Netfreak25/TB2-C3-Dev-Shield/assets/pcb-top.png

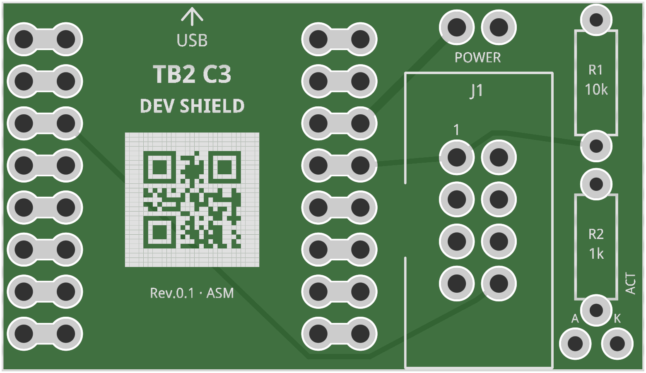
assets/pcb-top.png
