Netfreak25/TB2-C3-Dev-Shield/assets/schematic.png

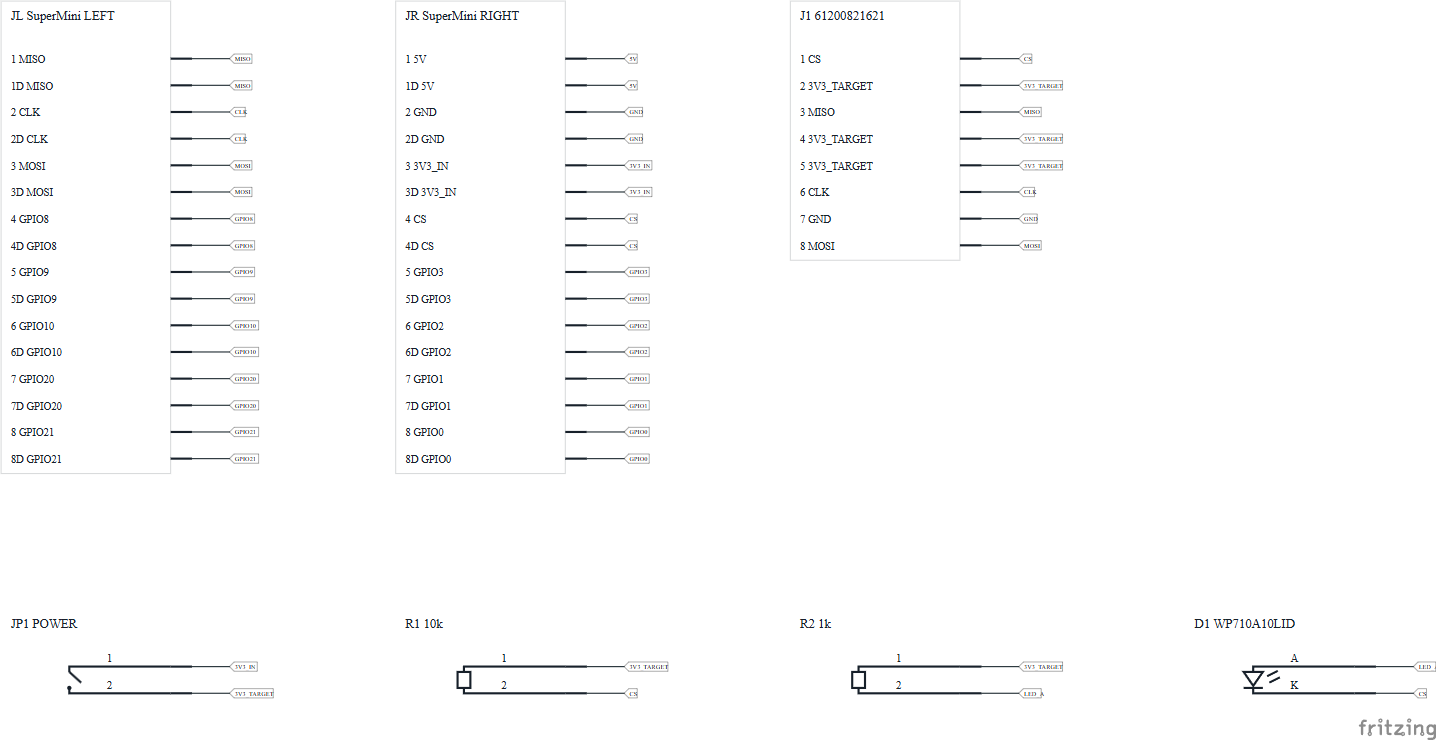
assets/schematic.png
