Netfreak25/TB2-C3-Dev-Shield/enclosure/model-b/exploded.png

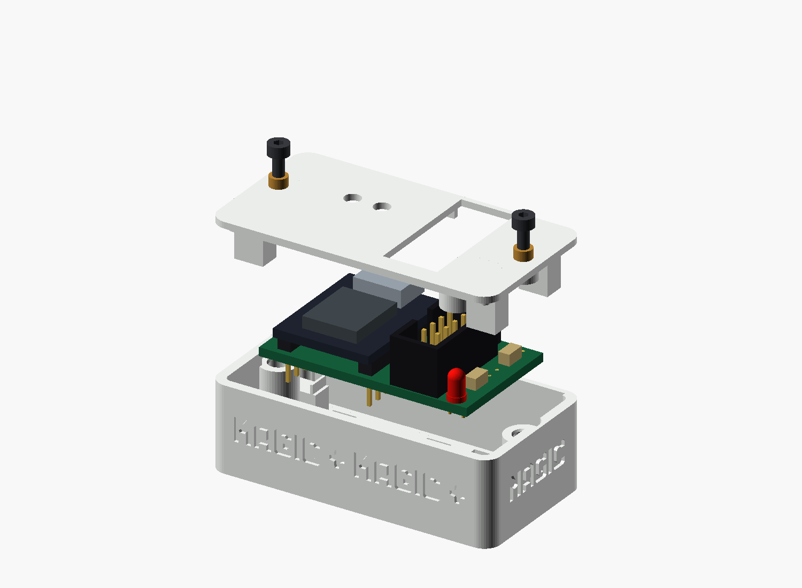
enclosure/model-b/exploded.png
