Netfreak25/TB2-C3-Dev-Shield/enclosure/model-b/led_section.png

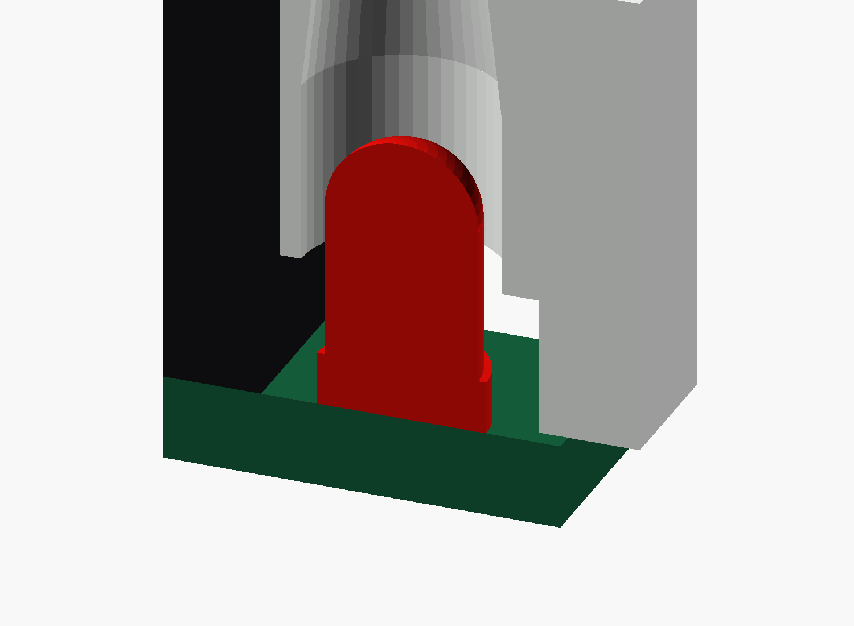
enclosure/model-b/led_section.png
