Netfreak25/TB2-C3-Dev-Shield/enclosure/model-b/usb_front.png

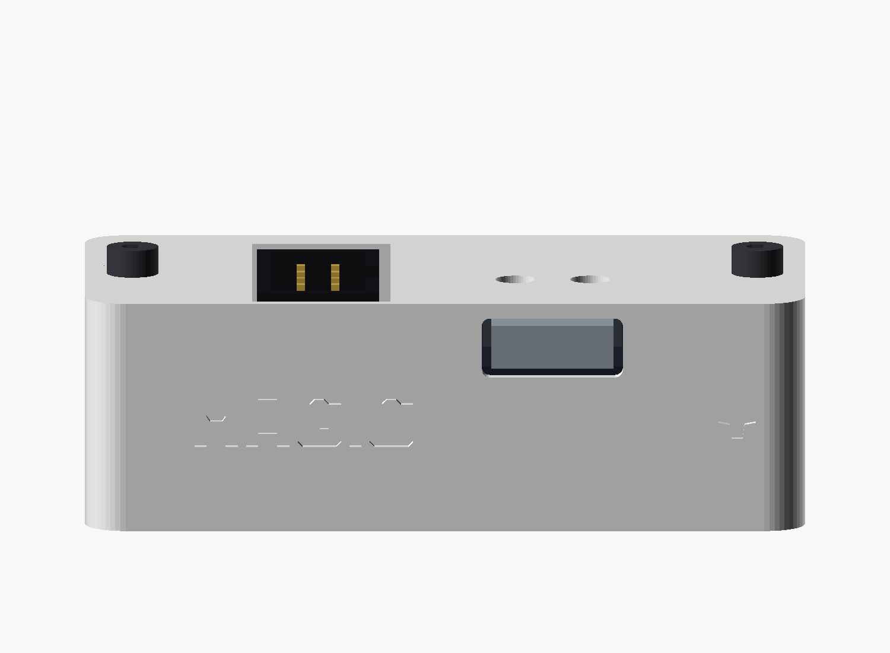
enclosure/model-b/usb_front.png
