Netfreak25/TB2-C3-Dev-Shield/manufacturing/pcbway/BOM.csv

Designator | Quantity | Description | Value | Footprint | Manufacturer | MPN | Mounting | Notes | Datasheet
JL,JR | 2 | Female socket strip 1x8 | 2.54 mm; 8.5 mm body height | THT; body 20.82 x 2.5 mm | Wurth Elektronik | 61300811821 | THT TOP | Inner rows only; sockets open upward; 15.24 mm row spacing. | https://www.we-online.com/components/products/datasheet/61300811821.pdf
J1 | 1 | Straight vertical shrouded Stecker 2x4 | 2.54 mm | THT; body 9.0 x 17.82 mm | Wurth Elektronik | 61200821621 | THT TOP | Notch LEFT; opening UP; pin 1 at USB end. Do not fit a right-angle type. | https://www.we-online.com/components/products/datasheet/61200821621.pdf
JP1 | 1 | Power header 1x2 WITHOUT SHUNT | 2.54 mm; 6 mm mating pins | THT; 1.10 mm PCB holes | Wurth Elektronik | 61300211121 | THT TOP | Fit the two-pin header only. DO NOT supply or fit a removable shunt. Leave open. | https://www.we-online.com/components/products/datasheet/61300211121.pdf
R1 | 1 | CS pull-up resistor | 10 kohm; 1%; 0.25 W | THT axial; form leads to 7.62 mm; body max 3.7 x 2.1 mm | Yageo | MFR25SFTE52-10K | THT TOP | Equivalent by stated specs allowed; horizontal body; no polarity. | https://yageogroup.com/content/datasheet/asset/file/YAGEO-MFR_DATASHEET
R2 | 1 | ACT LED series resistor | 1 kohm; 1%; 0.25 W | THT axial; form leads to 7.62 mm; body max 3.7 x 2.1 mm | Yageo | MFR25SFTE52-1K | THT TOP | Equivalent by stated specs allowed; horizontal body; no polarity. | https://yageogroup.com/content/datasheet/asset/file/YAGEO-MFR_DATASHEET
D1 | 1 | Red low-current ACT LED | 3 mm red; low-current indicator | THT; 2.54 mm pitch | Kingbright | WP710A10LID | THT TOP | Anode LEFT; cathode RIGHT (flat side). Mount upright; verify datasheet polarity. | https://www.kingbrightusa.com/images/catalog/SPEC/WP710A10LID.pdf
