Netfreak25/TB2-C3-Dev-Shield/enclosure/model-b/TB2_C3_Case_B_corrected.3mf

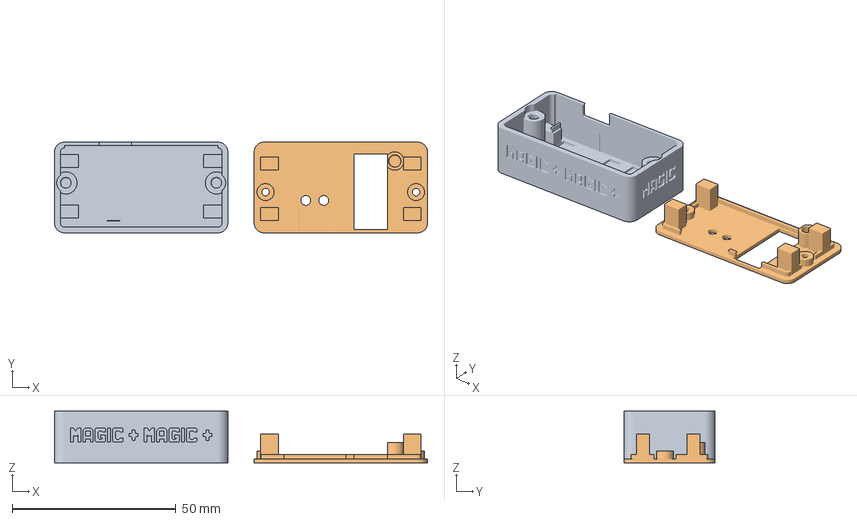
[picture p17: CAD file, 2026-10-26]
enclosure/model-b/TB2_C3_Case_B_corrected.3mf
114.0 x 27.7 x 15.8 mm
Base
Lid
