Netfreak25/TB2-C3-Dev-Shield/enclosure/TB2_C3_Case_base.stl

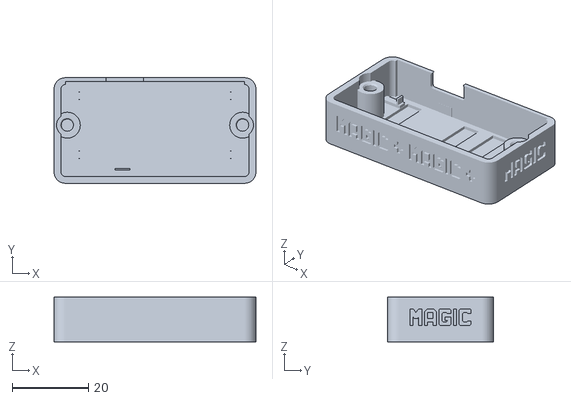
[picture p18: CAD file, 2026-10-26]
enclosure/TB2_C3_Case_base.stl
53.0 x 27.7 x 11.8
