Netfreak25/TB2-C3-Dev-Shield/enclosure/TB2_C3_Case_lid.stl

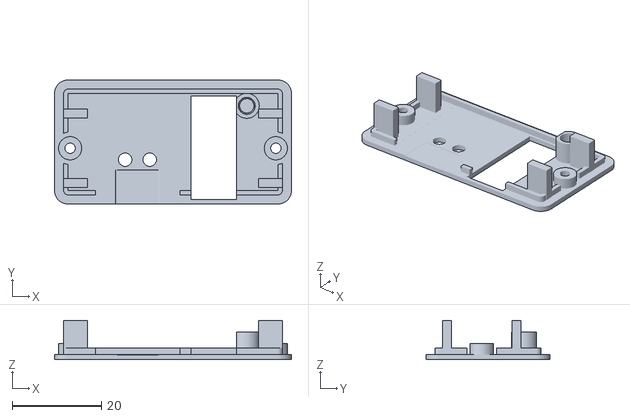
[picture p20: CAD file, 2026-10-26]
enclosure/TB2_C3_Case_lid.stl
53.0 x 27.7 x 8.80
