Netfreak25/TB2-C3-Dev-Shield/enclosure/model-b/TB2_C3_Case_base.stl

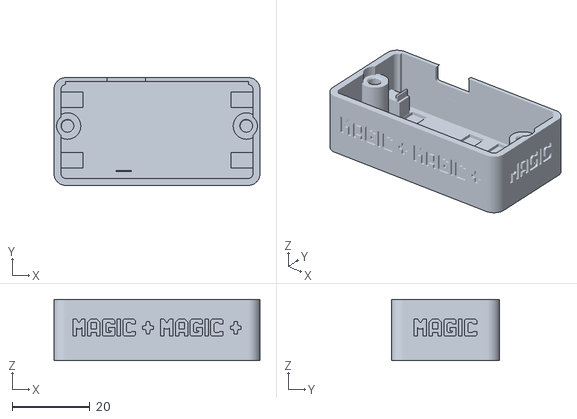
[picture p21: CAD file, 2026-10-26]
enclosure/model-b/TB2_C3_Case_base.stl
53.0 x 27.7 x 15.8
