Netfreak25/TB2-C3-Dev-Shield/(list of files, drawings)

Other design files:
hardware/TB2-C3-Dev-Shield-Assembly-Rev0.1.fzz
