Netfreak25/TB2-C3-Dev-Shield/(commit log)

2026-10-10 Publish TB2 C3 Dev Shield Rev. 0.1 hardware and manufacturing files
    [BOM.csv, TB2-C3-Dev-Shield-Assembly-Rev0.1.fzz, THT-positions.csv]
2026-10-14 Add printable flat dock for the socket-mounted C3 shield
    [TB2_C3_Case.scad, TB2_C3_Case_base.stl, TB2_C3_Case_lid.stl]
2026-10-14 Restore white MAGIC styling and single-layer ACT cover
    [TB2_C3_Case.scad, TB2_C3_Case_base.stl, TB2_C3_Case_lid.stl]
2026-10-14 Correct enclosure handedness against the PCB top view
    [TB2_C3_Case.scad, TB2_C3_Case_base.stl, TB2_C3_Case_lid.stl]
2026-10-14 Add integral ACT light guide to enclosure Rev. 0.4
    [TB2_C3_Case.scad, TB2_C3_Case_base.stl, TB2_C3_Case_lid.stl]
2026-10-25 Add ESP32-C3 flasher v0.1 and first-dump guide
2026-10-25 Document PowerShell serprog first-dump workflow
2026-10-25 Keep C3 target power stable after chip detection
2026-10-25 Add front USB access relief to C3 dock Rev. 0.5
    [TB2_C3_Case.scad, TB2_C3_Case_base.stl, TB2_C3_Case_lid.stl]
2026-10-25 Fit flat dock to directly soldered C3 and mated USB cable
    [TB2_C3_Case.scad, TB2_C3_Case_base.stl, TB2_C3_Case_lid.stl]
2026-10-25 Lower C3 shield in closed flat dock
    [TB2_C3_Case.scad, TB2_C3_Case_base.stl, TB2_C3_Case_lid.stl]
2026-10-26 Enclose USB-C port on C3 dock Rev 0.8
    [TB2_C3_Case.scad, TB2_C3_Case_base.stl, TB2_C3_Case_lid.stl]
2026-10-26 Add 4.5 mm ESP pin variant for C3 enclosure
    [TB2_C3_Case.scad, TB2_C3_Case_B.scad, TB2_C3_Case_base.stl, TB2_C3_Case_lid.stl]
2026-10-26 Provide full 4.5 mm pin clearance below the shield in Model B
    [TB2_C3_Case.scad, TB2_C3_Case_B.scad, TB2_C3_Case_B_corrected.3mf, TB2_C3_Case_base.stl, TB2_C3_Case_lid.stl]
